martis2580/Outdated-Volvo-Nav-Retrofit/pics/Android_auto_display_2.jpg

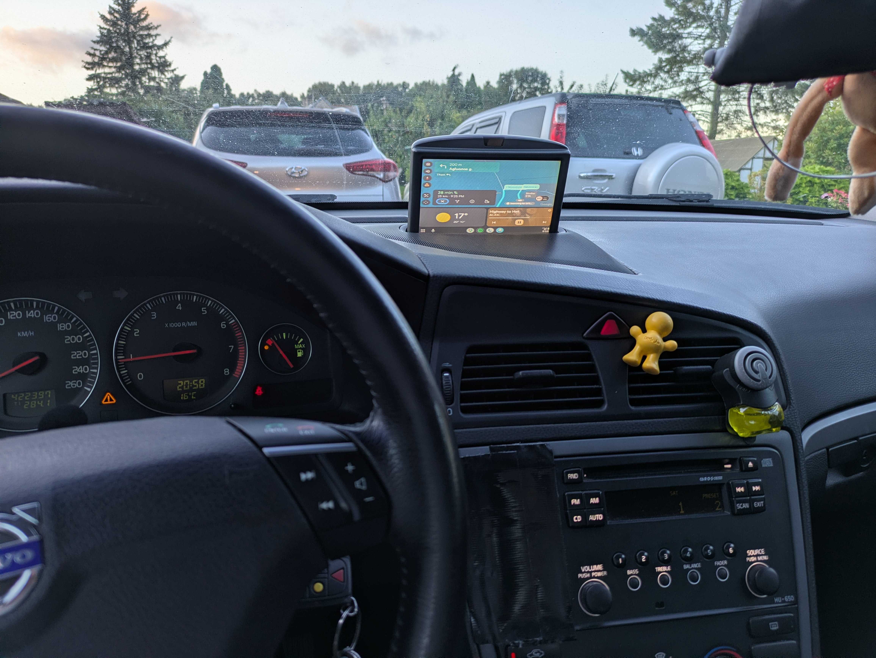
pics/Android_auto_display_2.jpg
