martis2580/Outdated-Volvo-Nav-Retrofit/pics/Arduino_power_supply_circuit.jpg

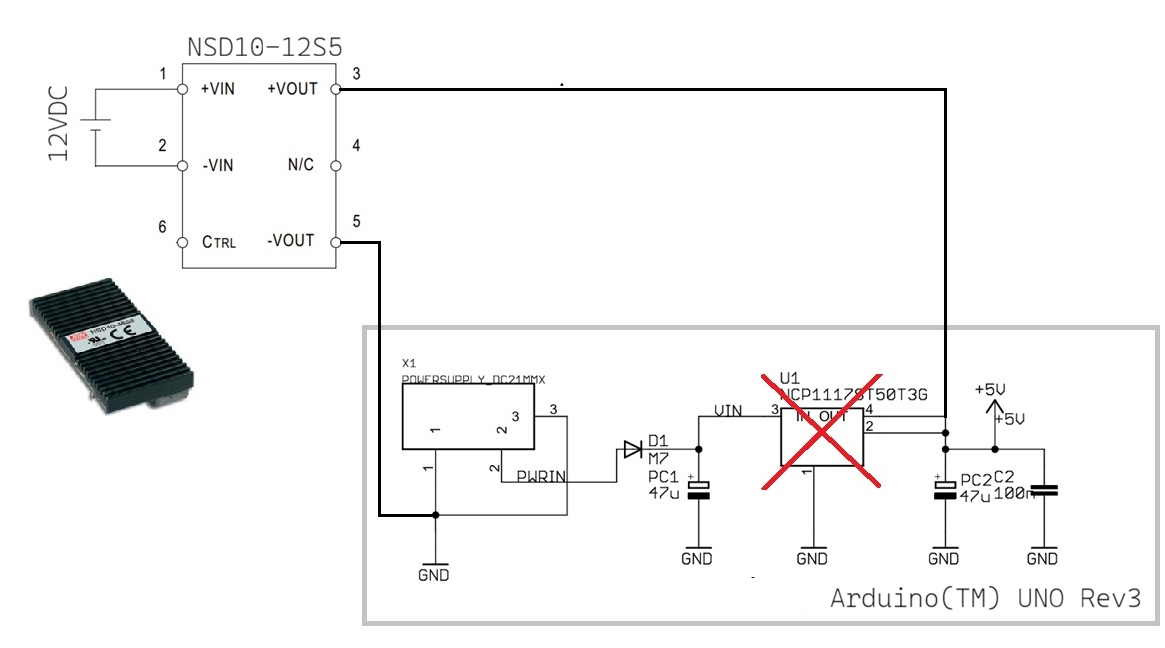
pics/Arduino_power_supply_circuit.jpg
