martis2580/Outdated-Volvo-Nav-Retrofit/pics/Audio_schematic.png

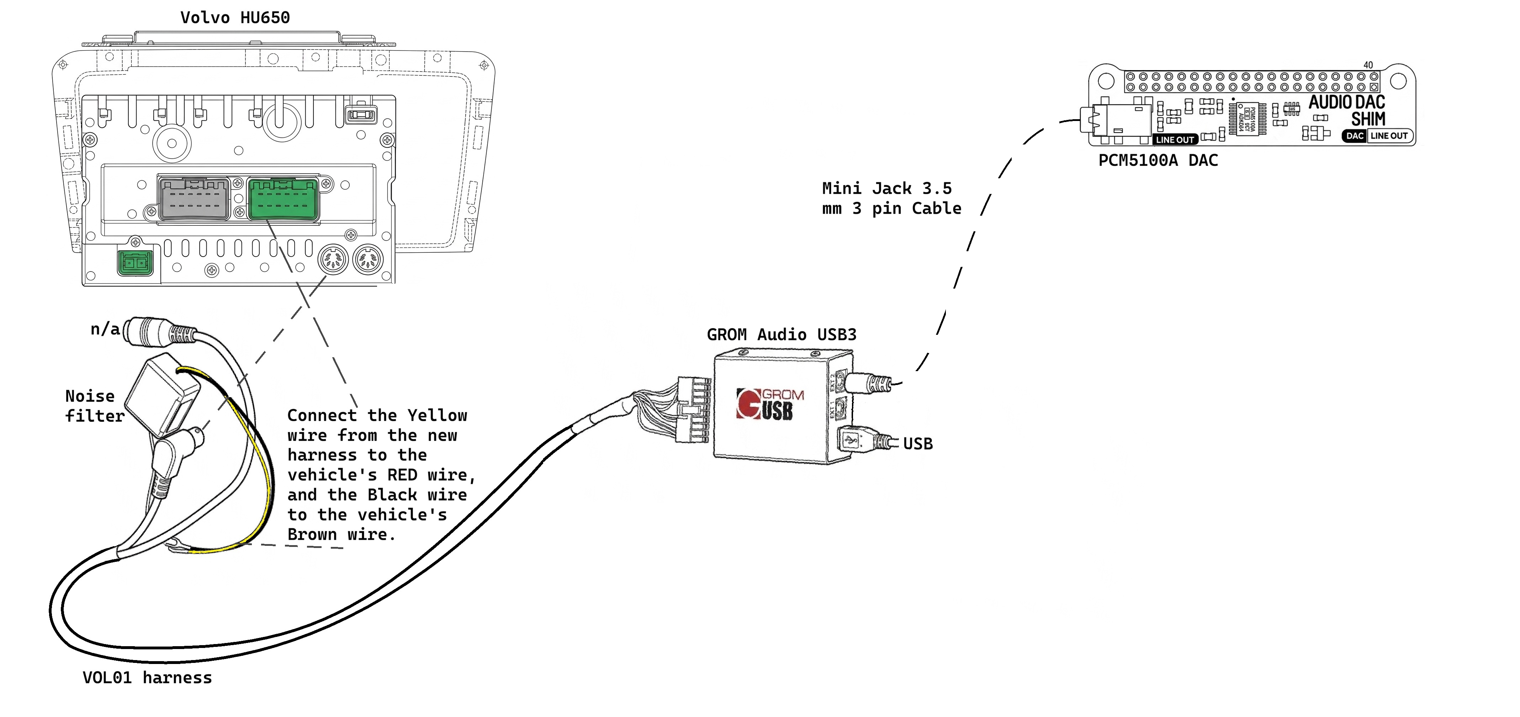
pics/Audio_schematic.png
