martis2580/Outdated-Volvo-Nav-Retrofit/pics/AUM_pinout.png

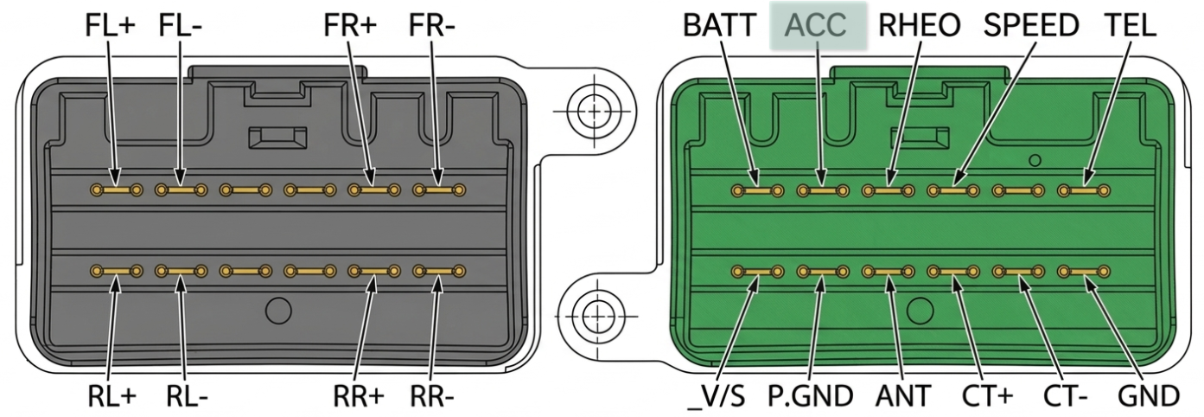
pics/AUM_pinout.png
