martis2580/Outdated-Volvo-Nav-Retrofit/firmware/arduino_power_supervisor/can_handler.cpp

#include <Arduino.h>
#include <SPI.h>
#include <mcp_can.h>

#include "config.h"
#include "state_machine.h"
#include "can_handler.h"

static MCP_CAN CAN(CAN_CS_PIN);
static const bool CAN_USE_LISTEN_ONLY = true;

void initCan()
{
  while (CAN.begin(MCP_STDEXT, CAN_125KBPS, MCP_16MHZ) != CAN_OK)
  {
    delay(500);
  }

  if (CAN_USE_LISTEN_ONLY)
  {
    CAN.setMode(MCP_LISTENONLY);
  }
  else
  {
    CAN.setMode(MCP_NORMAL);
  }
}

void processCan()
{
  while (CAN_MSGAVAIL == CAN.checkReceive())
  {
    unsigned long now = millis();
    uint32_t id = 0;
    uint8_t len = 0;
    uint8_t buf[8];
    uint8_t ext = 0;
    CAN.readMsgBuf(&id, &ext, &len, buf);
    noteCanFrameReceived(now);

    if (id == IGNITION_CAN_ID && len > IGNITION_BYTE_INDEX)
    {
      uint8_t ignitionByte = buf[IGNITION_BYTE_INDEX] & IGNITION_ON_MASK;
      bool ignitionOn = ignitionByte == IGNITION_ON_VALUE
        || ignitionByte == IGNITION_ON_ALT_VALUE_1
        || ignitionByte == IGNITION_ON_ALT_VALUE_2;
      processIgnitionFrame(ignitionOn, now);
    }
  }
}
