martis2580/Outdated-Volvo-Nav-Retrofit/(commit log)

2026-04-19 Include LIN bus sniffing diagram in README
    Added LIN bus sniffing wiring diagram to README.
2026-04-19 Add decoded signal table to README
    Added a decoded signal table for LIN bus button events.
2026-04-19 Update image links for button signals in README
    Updated image sources for button signals in the README.
2026-04-19 Remove separator line from button mapping table
    Removed the separator line in the button mapping section.
2026-04-19 Update README with connector pinout specifications
    Added vehicle-side connector pinout specifications to README.
2026-04-19 Update README with connector details and images
    Added images and terminal information for connectors.
2026-04-19 Fix formatting in README.md for connector table
2026-04-19 Add more pics
    SWM connector
2026-04-19 Fix image path for Connector 1 in README
    Updated image path for Connector 1 in README.
2026-04-19 Fix image formatting for connectors in README
    Updated image syntax for connectors in README.
2026-04-19 Revise connector images and table layout in README
    Updated connector images and table formatting in README.
2026-04-19 Fix connector image URLs in README
    Updated connector images in the README.
2026-04-19 Swap images for SWM connectors in README
2026-04-19 Update vehicle-side connector pinout specifications
    Rearranged connector pinout specifications and updated images.
2026-04-20 Add files via upload
    Steering_wheel_nav_button
2026-04-20 Update README with vehicle-side connector pinout
    Added vehicle-side connector pinout specifications section to README.
2026-04-20 Adjust image width for steering wheel nav button
    Updated image width for better display on README.
2026-04-20 Update README with NAV button installation source
    Added a note about the NAV button installation guide's source.
2026-04-20 Enhance README with NAV button installation details
    Added a note about the NAV button installation guide's source and visualization style.
2026-04-20 Update README with LIN bus sniffing details
    Added information about steering wheel button events and LIN bus sniffing.
2026-04-20 Update README with nav button installation details
    Clarified the installation process for the nav button module and explained the challenges with steering wheel button events on the CAN gateway.
2026-04-20 Update README with LIN bus sniffing details
    Added a reference to the electrical schematic for LIN-USB integration.
2026-04-20 Add LIN bus sniffing wiring diagram to README
    Added an image of the LIN bus sniffing wiring diagram to enhance understanding of the integration process.
2026-04-21 Update hardware list in README.md
    Added OEM Volvo steering wheel nav controls and RTI screen to the hardware list.
2026-04-21 Add 'Making LIN Work' section to README
    Added a section on making LIN work, detailing the retrofit process for the stock low-res RTI monitor and steering wheel button integration.
2026-04-21 Add SSD enclosure to hardware requirements
2026-04-24 Add USB 3.0 Y cable to hardware requirements
2026-04-24 Add flowchart for power distribution in README
    Added a flowchart to illustrate the power distribution for the project.
2026-04-24 Add Power Logic section to README
    Added a new section about the Power Logic with a flowchart.
2026-04-24 Included fuse box modif. photos
2026-04-24 Enhance README with power logic details
    Added information about power connections and fuse contact.
2026-04-24 Enhance README with NAV button installation info
    Added image and installation guide details to README.
2026-04-24 Revise image description and update NAV button info
    Updated the image description and removed the original installation guide reference.
2026-04-24 Fix image link in README for fuse contact
    Updated image source link for fuse contact comparison.
2026-04-24 Increase image width for fuse contact comparison
    Updated image width in README for better visibility.
2026-04-24 Update README with wiring diagram and image
    Added image and wiring diagram for retrofit installation.
2026-04-24 Update README with power connection details
    Added details about power connections and fuse layout for the RTI monitor and components.
2026-04-25 Update README with passenger compartment fuse table
2026-04-25 Update FuseBox reference in flowchart
2026-04-25 Update README with RTI display ignition signal details
    Added information about the RTI display ignition signal and included a flowchart for better understanding.
2026-04-25 Enhance README with images and flowchart
    Added table with images and flowchart for setup instructions.
2026-04-26 Add mermaid flowchart for F13_KL30 connections
2026-04-26 Add mermaid diagram for power logic
    Added a mermaid diagram illustrating the power logic.
2026-04-26 Update README with grounding details and images
    Added grounding information and images to README.
2026-04-26 Adjust image sizes for grounding point in README
    Updated image dimensions in the grounding section.
2026-04-26 Revise hardware section to BOM format
    Updated section header and provided a detailed BOM for hardware components.
2026-04-27 Update README with shutdown procedures and BOM details
    Added information about safe shutdown procedures and hardware selection for the Raspberry Pi project.
2026-04-27 Enhance README with flowchart and BOM details
    Added a flowchart to illustrate the system start-up and shutdown sequence for the Raspberry Pi project, along with a BOM of hardware components.
2026-04-28 Update README with Arduino watchdog and shutdown details
    Clarified the role of the Arduino in safely shutting down the Raspberry Pi and added details about the new watchdog feature that monitors CAN traffic before booting the Raspberry Pi.
2026-04-28 Enhance README with power management details
    Updated the README to clarify the implementation of an Arduino-based CAN watchdog and power supervisor for the Raspberry Pi, including details on power management and system shutdown sequences.
2026-04-28 Revise power management flowchart in README
    Updated flowchart in README to reflect new control logic for Raspberry Pi power management.
2026-04-28 Update relay activation message in README
2026-04-28 Update flowchart for IGN message handling
2026-04-28 Update README with ignition message validation flow
    Added new flowchart steps for message validation and ignition activation.
2026-04-29 Update README with CAN message mapping and BOM
    Added CAN message mapping details and BOM for hardware.
2026-05-02 Add Volvo P2 CAN communication details and BOM updates
    Added important information about the Volvo P2 low-speed CAN communication bit rate and updated the BOM of Hardware section.
2026-05-04 Add BOM of Hardware and Software sections
    Added BOM of hardware and software requirements to README.
2026-05-04 Add instructions for Volvo pop-up screen modification
    Added section on reviving the Volvo pop-up screen with embedded gear and provided pinout specifications.
2026-05-04 Update README with RTI Display connectors pinout
    Added pinout specifications for RTI Display connectors.
2026-05-13 Add section on headunit and factory audio integration
    Added a section on building a bridge between the new headunit and the factory audio system, detailing the use of a Raspberry Pi 5 and Pimoroni Audio DAC SHIM.
2026-05-16 Add table for RTI Display and OEM Wiring Harness images
    Added a table to display images of the Volvo P2 RTI Display and OEM Wiring Harness.
2026-05-31 Update README with wire color details for connections
    Added wire color information for display connections.
2026-06-01 Add composite output setup instructions for Pi 5
    Added instructions for enabling composite output on Raspberry Pi 5.
2026-06-10 Update README with Raspberry Pi USB setup instructions
    Added notes on preventing backfeeding into Raspberry Pi and EEPROM configuration for USB boot delay.
2026-06-15 Add files via upload
    Attached audio schematic
2026-06-15 Update README with GROM audio adapter details
    Added electrical schematic and installation guide for GROM audio adapter integration.
2026-06-18 Change voltage from 9V to 5V for Arduino Uno
    Updated voltage specification for Arduino Uno connection.
2026-06-18 Modify flowchart in README for voltage outputs
    Updated flowchart to reflect changes in voltage outputs for components.
2026-06-18 Update README with clarification on steering wheel buttons
    Clarified that steering wheel button events were checked for vehicles without factory-installed RTI.
2026-06-19 Add FAKRA coaxial cable assembly to README
    Added FAKRA coaxial cable assembly to the hardware list.
2026-06-21 Add GROM audio EXT2 connector pinout specification
    Added GROM audio EXT2 connector pinout specification to the README.
2026-06-21 Revise section title and enhance power management details
    Updated section title and provided details on power management for the retrofit navigation system.
2026-06-21 Revise Power Management section in README
    Updated section title and added details about power management and hardware supervisor integration.
2026-07-13 Add DC 5V Relay Module to the components list
2026-07-13 Add an electrical circuit diagram.
    Add an electrical circuit diagram.
2026-07-13 Rename 'Main Electrical Diagram' to 'Wiring Diagram'
2026-07-14 Enhance README with project details and assembly info
    Added detailed description of the Arduino-based CAN watchdog and power supervisor unit, including hardware requirements and assembly instructions.
2026-07-14 Update README with power supply circuit image
    Added a schematic image and description for the power supply modification.
2026-07-14 Add Raspberry Pi LIN setup guide
    This guide provides steps for configuring a Raspberry Pi for LIN communication.
2026-07-14 Add link to Raspberry Pi LIN Setup documentation
2026-07-14 Update README with final assembly information
    Added final assembly details and images of the CAN watchdog and power supervisor unit.
2026-07-15 Update README with Volvo LIN baud rate and setup info
    Added specific baud rate information for Volvo P2 S60 LIN communication and included a link to Raspberry Pi LIN setup.
2026-07-15 Update Raspberry Pi LIN setup to Volvo LIN Bridge
    This document provides detailed instructions for setting up the Volvo LIN bridge on a Raspberry Pi, including installation steps, configuration, and service management.
2026-07-16 Datasheet of PLS00548
    Ground Loop Isolator 3.5mm Stereo Plug to Socket
2026-07-16 Add Ground Loop Isolator to components list
    Added Ground Loop Isolator to the list of components.
2026-07-16 Replace audio schematic image with updated version
    Updated the schematic image to include ground isolator.
2026-07-23 Modify flowchart for Arduino sleep mode logic
    Updated flowchart to reflect Arduino sleep mode in the loop.
2026-07-23 Update BOM with additional Raspberry Pi components
    Added Raspberry Pi RTC Battery
2026-07-24 Update README to reflect Arduino sleep mode
2026-08-01 Attached photo of RPi hardware final set up
    Attached photo of RPi hardware final set up
2026-08-01 Update README with Raspberry Pi final setup image
    Added an image and description for Raspberry Pi setup.
2026-08-01 Attached photo no. 2 of RPi hardware final set up
    Attached photo no. 2 of RPi hardware final set up
2026-08-01 Revise image layout and add new Raspberry Pi images
    Updated image display and added new image for Raspberry Pi setup.
2026-08-07 Update BOM with specific battery model
    Detailed RTC battery information
2026-08-07 Add field testing documentation
    Documented observations and recommendations regarding Raspberry Pi power loss during vehicle engine cranking tests.
2026-08-08 Add Arduino power supervisor script
2026-08-08 Revise future development features in ROADMAP.md
    Updated future development section with feature descriptions and removed OEM Temperature Sensor Integration.
2026-08-08 Attached photos
    Attached photos
2026-08-08 Revise project status in README
    Updated project status from 'Field Testing (FT)' to 'v1.0 — Initial Release'.
2026-08-09 Add Raspberry Pi RTC battery charging configuration
    Added configuration instructions for enabling RTC battery charging on Raspberry Pi.
2026-08-09 Add link to RASPBERRY_PI.md in README
    Added a reference to RASPBERRY_PI.md for additional configuration details.
2026-08-11 fix(ignition): treat 0x58, 0x98, and 0xD8 as active ignition frames
    fix(ignition): treat 0x58, 0x98, and 0xD8 as active ignition frames.
    Problem: when cruise control changes Byte 5 to 0x98 or 0xD8 , the Arduino would no longer see that frame as the active ignition state.
    [can_handler.cpp, config.h]
2026-10-11 Refactor Arduino power supervisor for CAN handling
